University-of-Nottingham-EEE-Projects/NEOBoard/NEOBoard Circuit Schematic.pdf

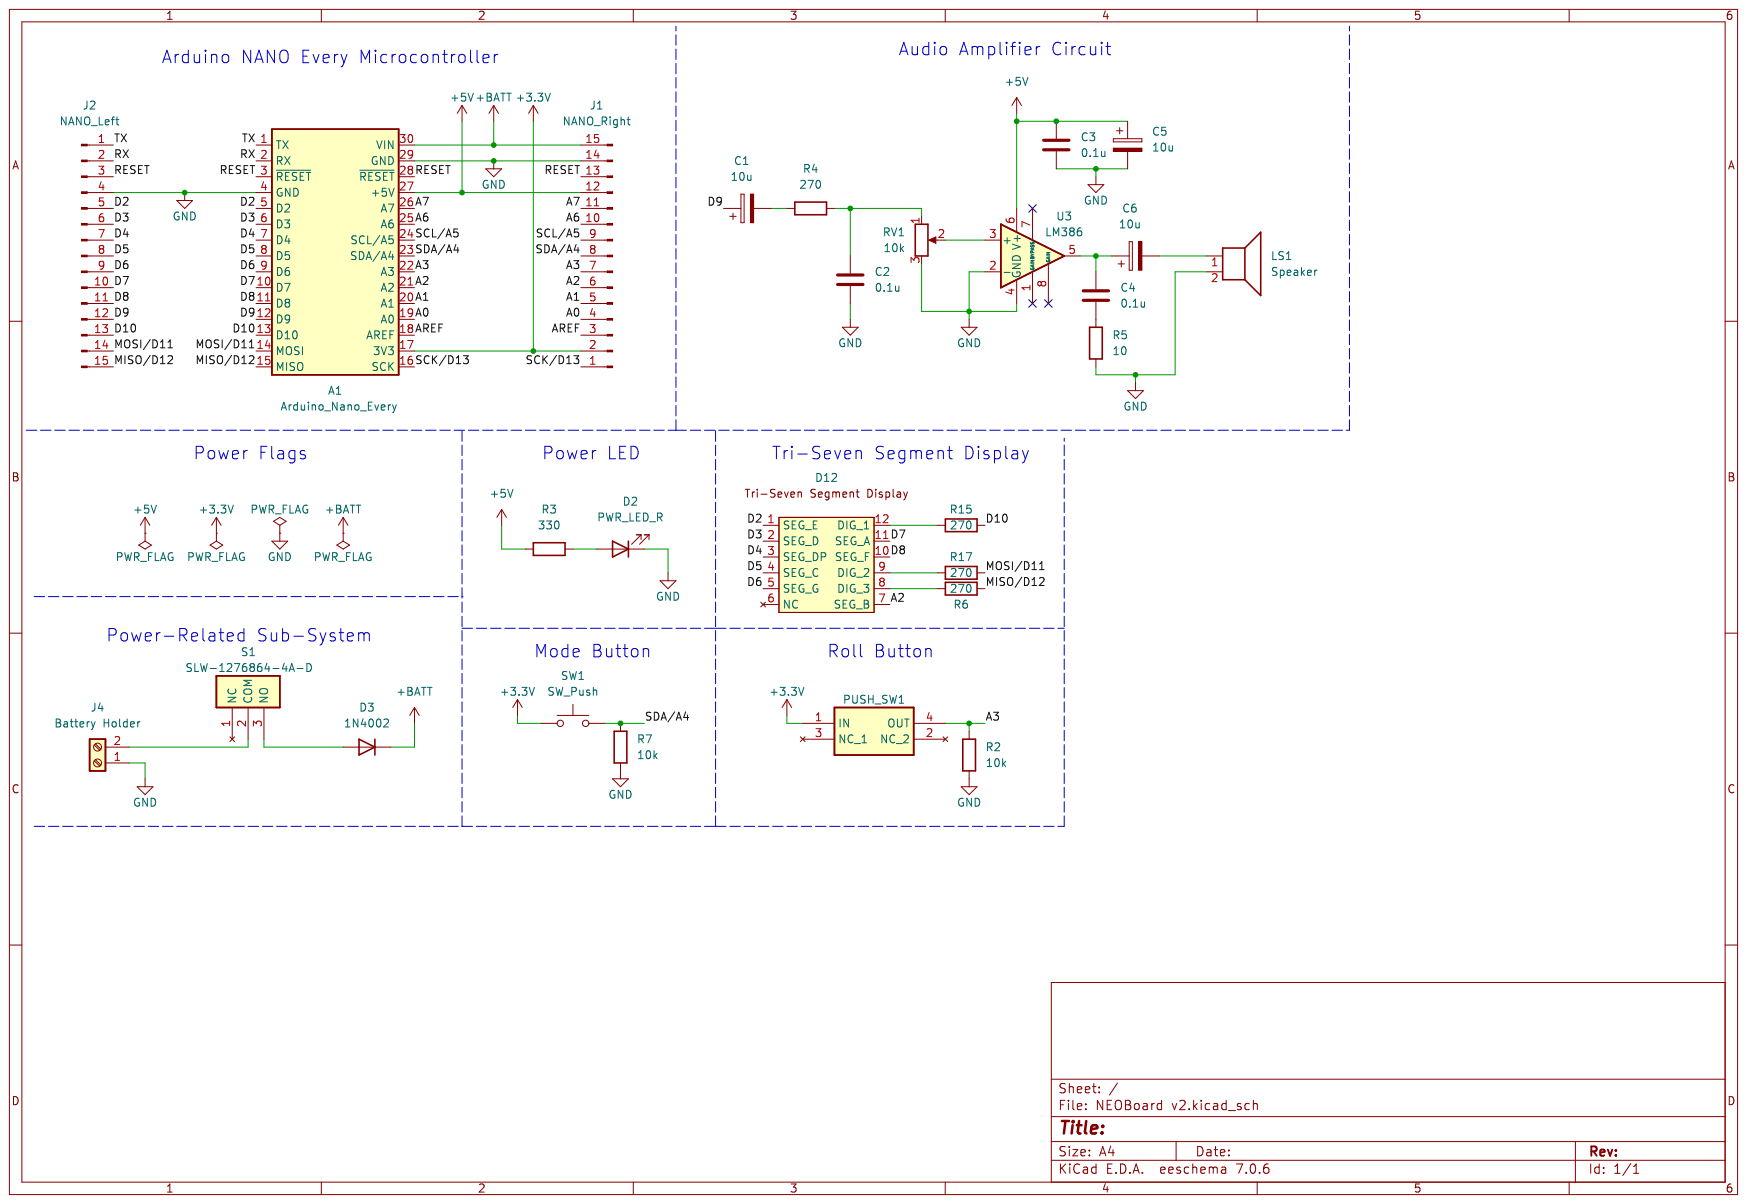
[picture p32: page 1]
